MERG-DEV/CAN4DC/README.md

# CAN4DC
4 DC PWM throttles

Uses PIC24HJ128GP502 and XC16 compiler.
