MERG-DEV/CAN4DC/pcb/4c_v8 4Mbus pcb.png

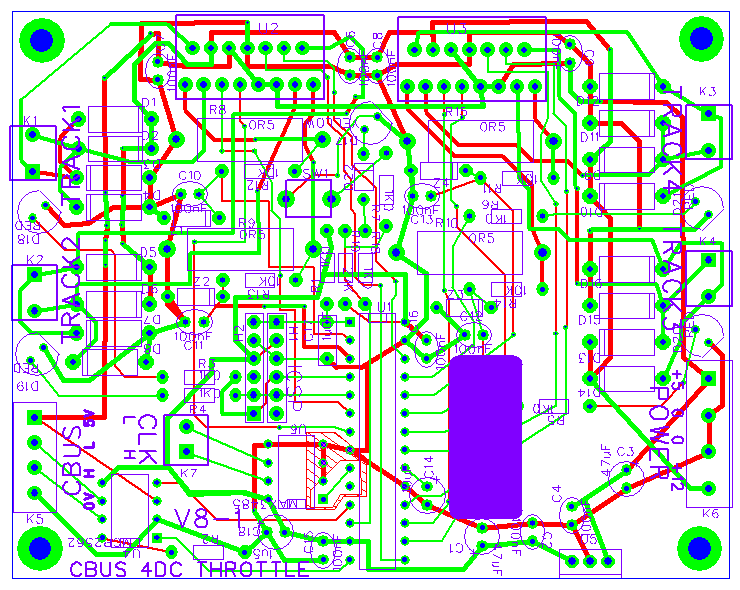
pcb/4c_v8 4Mbus pcb.png
