MERG-DEV/CAN4DC/pcb/4c_v8 4Mbus.png

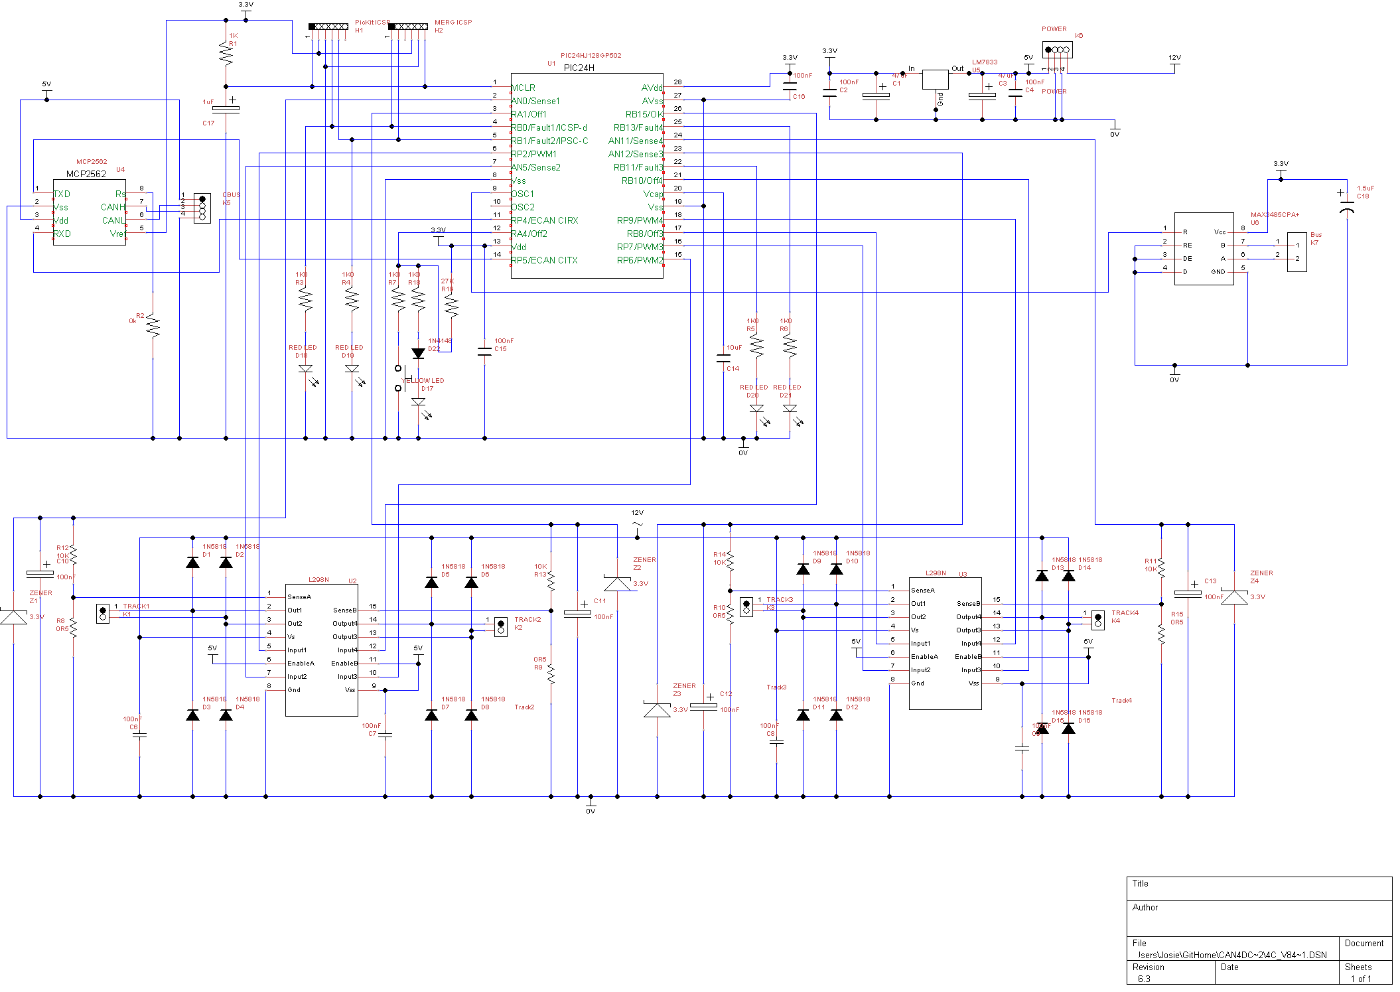
pcb/4c_v8 4Mbus.png
