MERG-DEV/CAN4DC/pcb/ClkGen.png

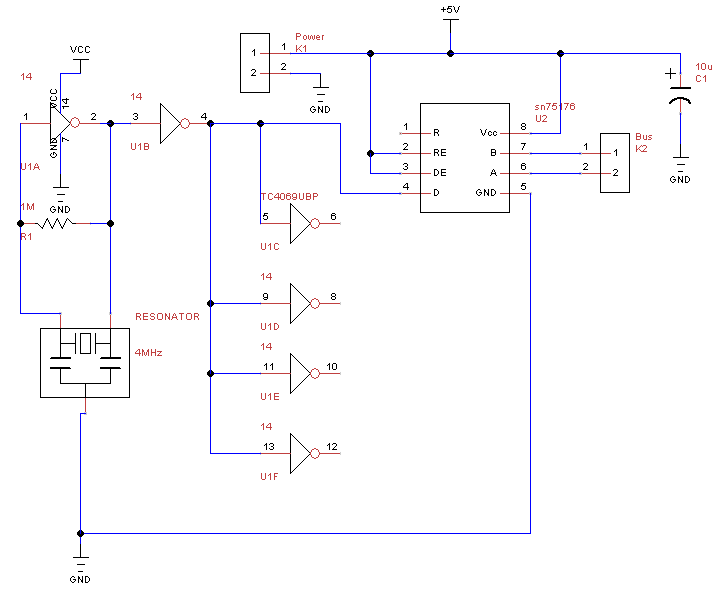
pcb/ClkGen.png
