MERG-DEV/CAN4DC/pcb/Clkgen_pcb.png

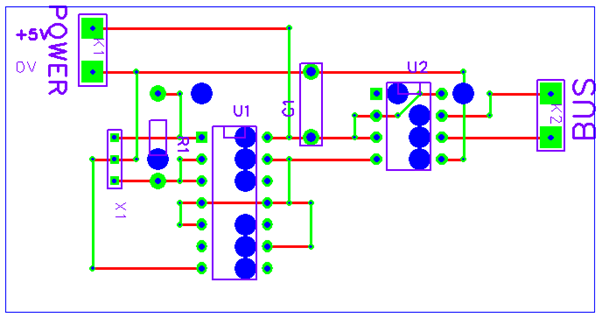
pcb/Clkgen_pcb.png
