MERG-DEV/CAN4DC/pcb/ClkRx.png

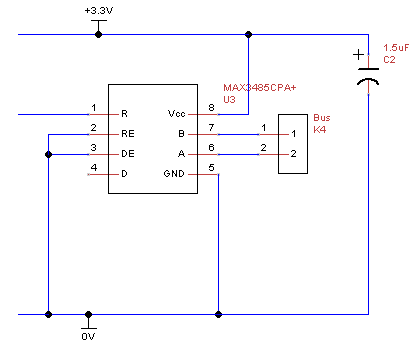
pcb/ClkRx.png
