MERG-DEV/CAN4DC/pcb/ClkRx_pcb.png

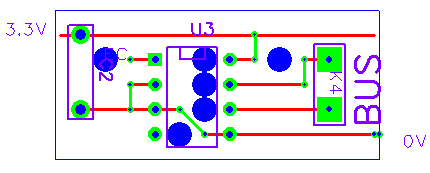
pcb/ClkRx_pcb.png
