MERG-DEV/CAN4DC/(list of files, drawings)

Other design files:
pcb/4c_v8 4Mbus.dsn
pcb/ClkGen.dsn
