MERG-DEV/CAN4DC/dma.h

/* 
 * File:   dma.h
 * Author: 	Ian Hogg
 * Comments:	Header file for the DMA functionality
 * Revision history: 
 */

#ifndef XC_DMA_H
#define	XC_DMA_H

#include <xc.h>

#ifdef	__cplusplus
extern "C" {
#endif /* __cplusplus */

extern void initDMA();

#ifdef	__cplusplus
}
#endif /* __cplusplus */

#endif	/* XC_DMA_H */
