MERG-DEV/CAN4DC/(notices)

Notices in the files:
cbusdefs8j.h:
This program is free software: you can redistribute it and/or modify
it under the terms of the GNU General Public License as published by
the Free Software Foundation, version 3 of the License, as set out
